AEFeinstein/Super-2024-Swadge-HW/README.md

# Super Magfest 2024 Swadge Hardware

## Welcome

This is the hardware repository for the Super Magfest 2024 Swadge.

The corresponding firmware repository for the Super Magfest 2024 Swadge [can be found here](https://github.com/AEFeinstein/Swadge-IDF-5.0).

If you have any questions, feel free to create a Github ticket or email us at circuitboards@magfest.org.

## Render

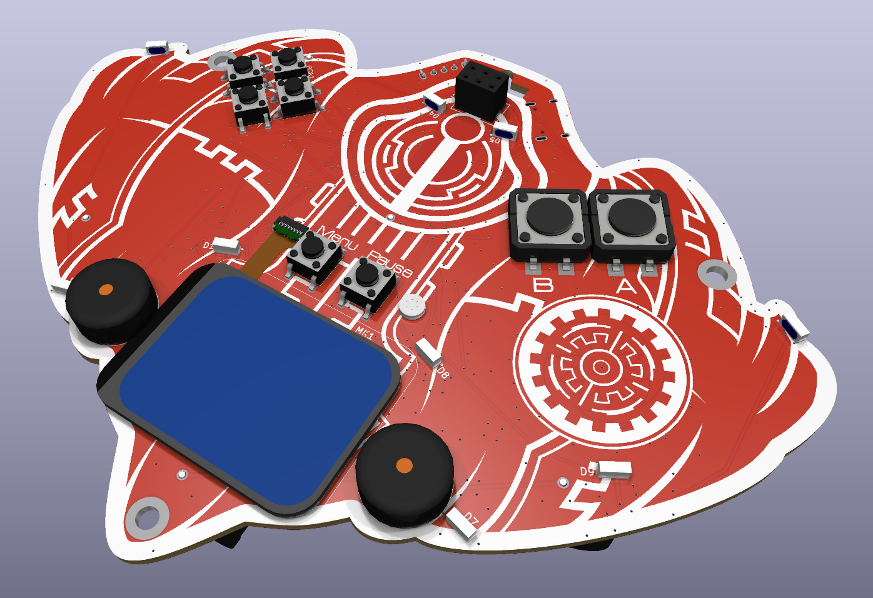
[picture p1: Swadge-HW/render.png]


## Schematic



## Directories

### `art`
This directory has the SVGs used to generate the KiCad files. The SVGs are drawn in [Inkscape](https://inkscape.org/) and exported with [Svg2Shenzhen](https://github.com/badgeek/svg2shenzhen)

### `Swadge-Parts`
This directory is a git submodule which has all the parts, footprints, and 3D models used in the KiCad project.

### `Swadge-HW`
This directory has the KiCad project for the main Swadge PCB.
