AEFeinstein/Super-2024-Swadge-HW/art/concept-art/Concept-Swadgeship-01.png

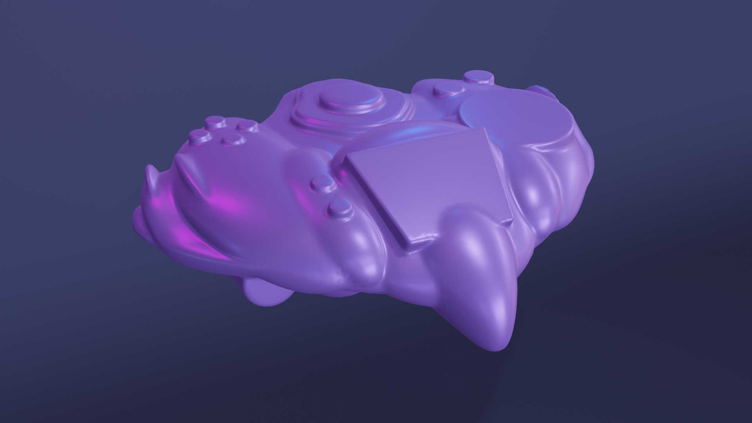
art/concept-art/Concept-Swadgeship-01.png
