AEFeinstein/Super-2024-Swadge-HW/art/concept-art/Ship-Original-Top.png

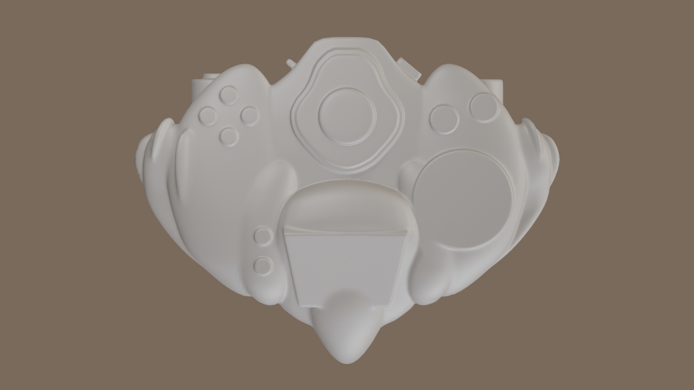
art/concept-art/Ship-Original-Top.png
