AEFeinstein/Super-2024-Swadge-HW/art/concept-art/zip_concept.jpg

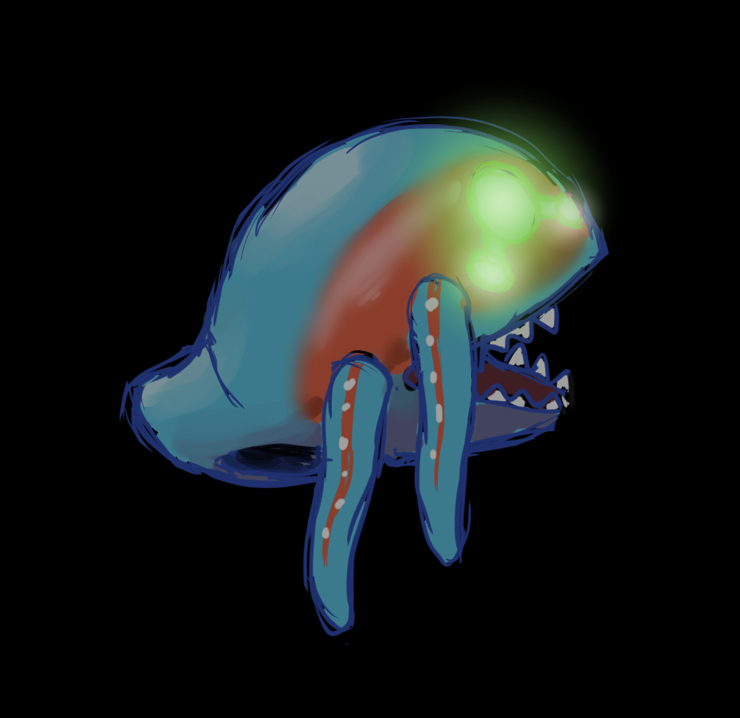
art/concept-art/zip_concept.jpg
