AEFeinstein/Super-2024-Swadge-HW/art/acrylic_3.dxf

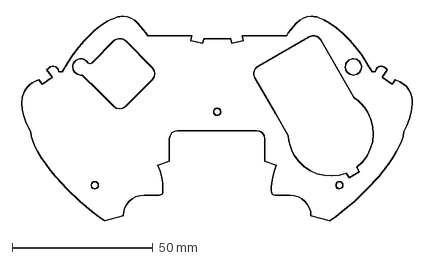
[picture p5: CAD file, 2023-09-23]
art/acrylic_3.dxf
144.3 x 72.8 mm
