AEFeinstein/Super-2024-Swadge-HW/Swadge-HW/3D-Print/GunShipShell_FDM.3mf

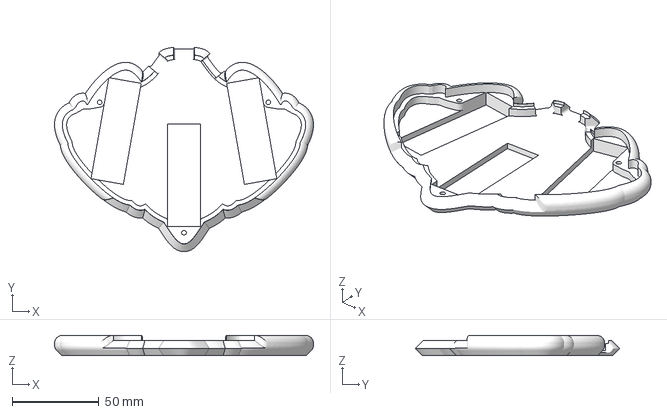
[picture p6: CAD file, 2023-09-25]
Swadge-HW/3D-Print/GunShipShell_FDM.3mf
149.0 x 117.5 x 11.6 mm
