AEFeinstein/Super-2024-Swadge-HW/Swadge-HW/package3d/acrylic-prototype_3.step

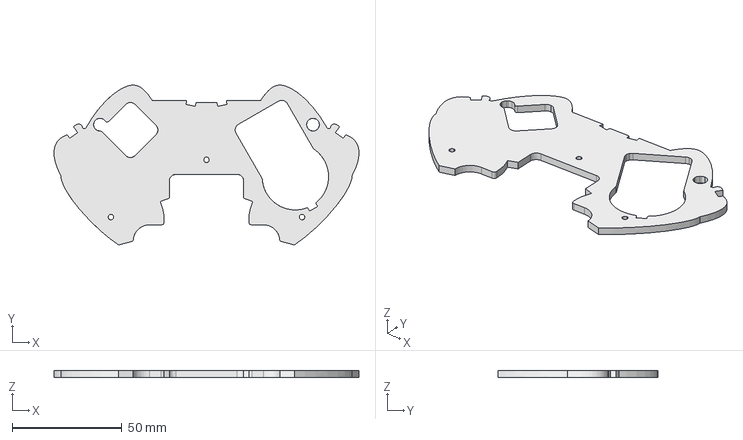
[picture p7: CAD file, 2023-09-23]
Swadge-HW/package3d/acrylic-prototype_3.step
138.9 x 72.8 x 3.00 mm
