AEFeinstein/Super-2024-Swadge-HW/art/acrylic_2.dxf

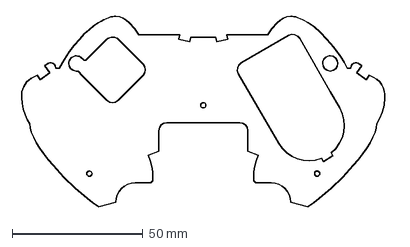
[picture p8: CAD file, 2023-09-05]
art/acrylic_2.dxf
144.3 x 72.8 mm
