AEFeinstein/Super-2024-Swadge-HW/Swadge-HW/package3d/acrylic-prototype.step

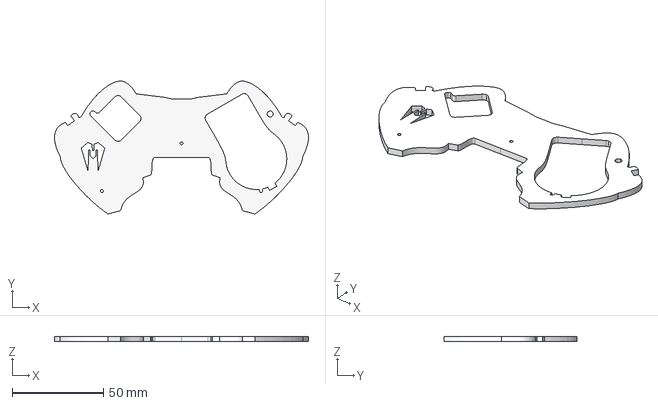
[picture p9: CAD file, 2023-07-24]
Swadge-HW/package3d/acrylic-prototype.step
138.9 x 72.7 x 3.00 mm
