AEFeinstein/Super-2024-Swadge-HW/Swadge-HW/3D-Print/Archive/ProtoShell02.3mf

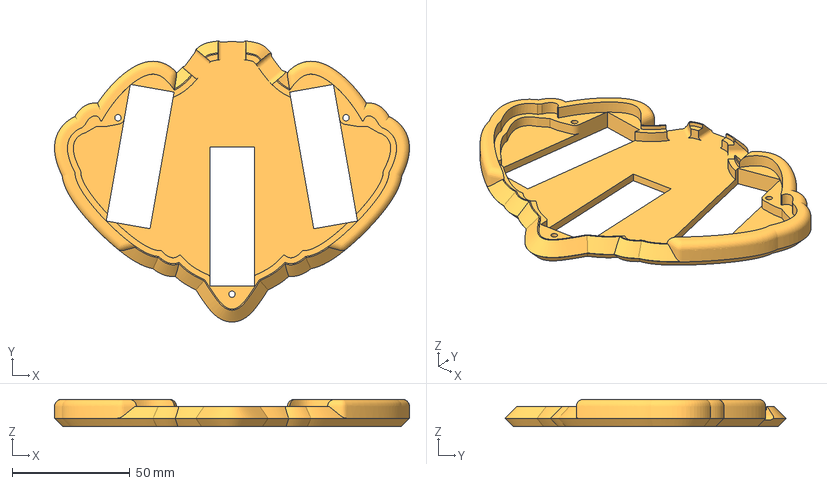
[picture p10: CAD file, 2023-09-15, an earlier design]
Swadge-HW/3D-Print/Archive/ProtoShell02.3mf
151.0 x 119.5 x 11.6 mm
