AEFeinstein/Super-2024-Swadge-HW/(list of files, cad)

Other CAD files:
Swadge-HW/3D-Print/Archive/ProtoShipShell02 v9.step
Swadge-HW/package3d/acrylic-prototype_2.step
Swadge-HW/3D-Print/Archive/ProtoShell02.stl
Swadge-HW/3D-Print/Archive/ProtoShipShell02 v9.stl
