AEFeinstein/Super-2024-Swadge-HW/(threads)

Thread 1 (2023-05-02):

Buzzer Improvements

AEFeinstein, 2023-05-02:
- [ ] Investigate a buzzer with a flatter frequency response (ZL-YDW1207-4005PA-5.0 favors high frequencies)
- [x] Investigate having two buzzers for stereo or polyphonic sound (budget permitting)
- [x] Investigate hardware mute switch rather than software setting

AEFeinstein, 2023-08-22:
Hardware mute isn't necessary with the quick setting menu.

I don't want to swap buzzers now, but this one would be a good candidate. It brings the resonant frequency down from 4000hz to 2300hz. It would require a footprint change

https://www.lcsc.com/product-detail/Buzzers_Jiangsu-Huaneng-Elec-HMB1206-03_C96101.html

Closed 2023-08-22.

Thread 2 (2023-05-02):

Microphone Improvements

AEFeinstein, 2023-05-02:
- [ ] Make sure Elecrow properly solders circuit. Is it possible to make it easier to solder?

cnlohr, 2023-06-07:
@AEFeinstein can you review:

Current microphone: [C2835889](https://www.lcsc.com/product-detail/Microphones_Goertek-B4013AM423-098_C2835889.html)

Microphone I've been playing with recently: (Is reverse-mount)
[C233789](https://www.lcsc.com/product-detail/MEMS-Microphones_Goertek-S08OB383-031_C233789.html)

AEFeinstein, 2023-06-07:
The reverse mount is like +$0.07, but otherwise appears to be a microphone. I'm not sure what you want me to review, but if you think the performance is worth the cost, we can at least put pads for it on the first proto.

cnlohr, 2023-06-07:
I do not feel strongly, but if there was ever a need/desire to have the component be not visible for artistic or other purposes, this is an option.

AEFeinstein, 2023-06-07:
Oh, if it's for aesthetics, I'm fine with the little button mic. I think that fits well as a detail on the gunship anyway. I'm mostly concerned with solderability, but maybe we can help elecrow out with a better footprint or something.

AEFeinstein, 2023-08-22:
The microphone on the first prototype didn't work, and this is noted in #11

AEFeinstein, 2023-09-26:
Mic on the second proto is A-OK

Closed 2023-09-26.

Thread 3 (2023-05-02):

LED Improvements

AEFeinstein, 2023-05-02:
- [x] Investigate acrylic diffuser. Elecrow now has an [acrylic cutting service](https://www.elecrow.com/acrylic-cutting.html). The following materials should be ordered and checked for optical properties
    * 000 - Transparent (probably too clear, engraving adds significant cost)
    * P422 - Matte Transparent (perhaps the only option)
    * 402 - White (check if translucent before ordering)
    * P402 - Matte White (check if translucent before ordering)
- [x] Investigate using cheaper SZLEDCO LEDs

AEFeinstein, 2023-06-07:
Test parts were ordered, waiting to receive and evaluate them

cnlohr, 2023-06-07:
Quote has been requested from SZLEDCO

AEFeinstein, 2023-08-22:
SZLEDCO are great

Closed 2023-08-22.

Thread 6 (2023-05-02):

Accelerometer Removal

AEFeinstein, 2023-05-02:
Unless a fair number of games or modes feature accelerometer control, remove it. It's not a great user experience to use it sparingly.

AEFeinstein, 2023-06-07:
Maybe. I don't remember current GPIO usage off the top of my head, but if we want a sixth pad for touch or a second buzzer line, they have to come from somewhere, and that somewhere could be the accel. Assuming GPIOs don't get stolen, I'm fine with just DNPing this

cnlohr, 2023-06-09:
considering we double-up these pins with the SAO header, that's another strike against that plan.

AEFeinstein, 2023-08-22:
Still unclear if these get removed or not, but it's covered in #11

Closed 2023-08-22.

Thread 7 (2023-05-02):

Power Circuitry Improvements

AEFeinstein, 2023-05-02:
- [x] Use physically smaller inductor
- [x] Don't place parts too close to battery footprint. The battery clip has some wiggle and can knock passives off

AEFeinstein, 2023-08-22:
@cnlohr I don't think you swapped the inductor. Either do that for the next rev or close this issue please.

AEFeinstein, 2023-08-30:
Smaller inductors have edges that may catch. Not swapping.

Closed 2023-08-30.

Thread 8 (2023-05-02):

Shape Improvements

AEFeinstein, 2023-05-02:
- [x] Make lanyard hole wide enough for plastic lanyard clips
- [x] Design shape with 3D printed shell in mind (mounting holes for shell? d-pad?)

Closed 2023-08-22.

Thread 11 (2023-08-14):

Rev- Fixes

cnlohr, 2023-08-14:
- [x] Microphone is laaaaaaame.  Switch to newly available microphone - https://www.lcsc.com/product-detail/Microphones_INGHAi-GMI4013S-2C58DB_C529870.html
- [x] Swap buttons (left/down)
- [x] Add copper behind the touch pad
- [x] Remove unused parts (gyro/accel/magnet), pending conversation
- [x] Add dot indicating pin 1 on SAO
- [x] Add silkscreen art
- [x] Move rear board components at least 2mm from board edge
- [x] Part movement and reroute. Move microphone from the nose to the gap between the menu/pause buttons and acrylic. Move the third screw hole from around the display to the nose. Delete the fourth screw hole around the display. Reroute as necessary. See quick example:
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

AEFeinstein, 2023-08-14:
And remove unused parts (magnetometer?)

cnlohr, 2023-08-15:
Add dot indicating pin 1 on SAO

AEFeinstein, 2023-08-15:
I strongly recommend adding copper behind the touch pad. I've noticed that the _back_ is touch sensitive on this rev, which isn't great.

AEFeinstein, 2023-08-15:
And I think we can get some art for rev2

AEFeinstein, 2023-08-23:
* cad972224555df497809eae80f3a85bdda3ab0e8 - Added dot to SAO
* a722288b943a128ea8e3cc8c8a3047e676b30b1c - Removed keepout behind touchpad
* c49fef01a56f8b0b280d5c99c38fbb450975cad4 - Swapped left and down buttons

eriktronic, 2023-08-27:
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
Move rear board components at least 2mm from board edge

cnlohr, 2023-08-28:
Change Log Summary, So far, in my new PR:
1. Move Microphone
2. Switch microphone for new mic.
3. Switch support circuitry for new mic.
4. Deleted extra screw.
5. Moved components on back in so that none are within 1mm of the edge.
6. Tweaked power for gyro.
7. Removed rumble drive circuitry.

Additional: Shrunk touch pad, it is now 24.5mm across.
Additional: Not sure why pinout on touchpad appeared different on updated touch pad - this should make them the same.

TODO:
- [ ] Add Silkscreen Art
- [ ] Pending, remove unused circuitry

AEFeinstein, 2023-08-28:
As noted in #14, once you remove unused circuitry give me the mutex and I'll apply art

cnlohr, 2023-08-29:
@AEFeinstein  Should I try using a smaller inductor for the display? It feels weird being the biggest chonker on the swadge.

cnlohr, 2023-08-29:
#14 Mutex released.

cnlohr, 2023-08-29:
Also - so you are aware, my new strategy is set min spacing to 7.2mil for DRC, and 8.2 for design.

That magnetometer is annoyying.

cnlohr, 2023-08-29:
Ugh... inductor wise, let's keep it.  All the other suitable ones look like they could snag. https://www.lcsc.com/product-detail/Inductors-SMD_Murata-Electronics-LQH32PZ100MNCL_C464437.html

AEFeinstein, 2023-08-29:
Keeping the more cube-ular inductor is A-OK.

AEFeinstein, 2023-08-30:
@cnlohr, I added art, tweaked some positions, and fixed DRC errors and warnings. I am done for the evening.

> Also - so you are aware, my new strategy is set min spacing to 7.2mil for DRC, and 8.2 for design.

FYI 8.2mil DRC for design threw a ton of errors, so I bumped it down to 0.2mm (7.87mil), which it looks like it was actually designed with. I also reassigned all track widths to their netclass width. It's nice.

> That magnetometer is annoyying.

Yes! I synced the board with `Swadge-Parts` so the footprint in use has pill-shaped pads, not rounded-square ones. I also overrode clearances for those four pads. I don't know what you want to do, but that'll be a quick chat before ordering.

Closed 2023-10-02.

Thread 13 (2023-08-26):

Scale down touch pad by 10-15%

Dacvak, 2023-08-26:

AEFeinstein, 2023-08-26:
What's the justification here?

cnlohr, 2023-08-29:
It both feels a tiiiny bit too big to me, and also it's harder to work through the deadzone.  By going to 24mm, and running our fingers around the far outside, we can have better control I feel.

When working on the shroud, be sure to add an edge beyond the size of the spinner, itself.

AEFeinstein, 2023-08-29:
I'll try to add a reasonable gap between the pad and the acrylic. I'll also be adding a courtyard to the part.

Closed 2023-08-30.

Thread 15 (2023-09-04):

Rev C fixes

cnlohr, 2023-09-04:
Just things I noticed post-submission
- [x] There is still silkscreen under antenna for esp - there should be no silkscreen.
- [x] R3's silkscreen is janked.
- [ ] Adjust C5 silkscreen to not look like "C51"
- [x] Try to hide front-side designator silkscreen under parts or acrylic (MK1, D1, J1)
- [x] We should have? or may (want)? to swap R10, R11 for 5.1k

AEFeinstein, 2023-09-05:
> There is still silkscreen under antenna for esp - there should be no silkscreen.

Does silkscreen impact RF performance? It's not metal...

cnlohr, 2023-09-26:
Not appreciably.  sorry, took til now to see this.

AEFeinstein, 2023-09-26:
Guess we're not changing the I2C pullups

cnlohr, 2023-10-02:
Sorry, forgot to mention - didn't want to change them.  We were already dropping the mag.

AEFeinstein, 2023-10-02:
> Adjust C5 silkscreen to not look like "C51"

Moved to #16

Closed 2023-10-02.

Thread 16 (2023-10-02):

Rev 1.0.0 Silkscreen Changes

AEFeinstein, 2023-10-02:
- [x] Add puzzle to the bottm
- [x]  Adjust C5 silkscreen to not look like "C51"

Current silkscreen:
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

AEFeinstein, 2023-10-08:
Done in 913542f40bd1546054c452497dc29488813f44fb

AEFeinstein, 2023-10-08:
@cnlohr FYI for silkscreen adjustments

Closed 2023-10-08.
