AEFeinstein/Super-2024-Swadge-HW/(commit log)

2023-05-02 Stripped out Super 2023 assets, erased layout, updated README.md
    [Eggshell_back_FDM.STL, Eggshell_back_SLA.STL, Eggshell_front_FDM.STL, Eggshell_front_SLA.STL, SAO1.kicad_pcb, SAO1.kicad_sch, Swadge-HW.kicad_pcb, Swadge-HW.kicad_sch]
2023-06-15 #1 Added second buzzer #5 Replaced touch strip with circular touch pad Moved TFT_FMARK to GPIO33 Added outline SVG
    [Swadge-HW.kicad_pcb, Swadge-HW.kicad_sch]
2023-06-16 Updated LEDs, started placement
    [Swadge-HW.kicad_pcb, Swadge-HW.kicad_sch]
2023-06-29 Rework shape and part placement
    [Swadge-HW.kicad_pcb]
2023-07-04 Flipped Swadge over
    [Swadge-HW.kicad_pcb]
2023-07-05 Flipped Swadge back over (undo)
    [Swadge-HW.kicad_pcb]
2023-07-05 Place LEDs, lose my mind
    [Swadge-HW.kicad_pcb]
2023-07-06 Adjust LED placement, ready for routing
    [Swadge-HW.kicad_pcb, Swadge-HW.kicad_sch]
2023-07-06 SCH cleanup, added missing D9 connections
    [Swadge-HW.kicad_pcb, Swadge-HW.kicad_sch]
2023-07-07 Add courtyards for parts, move D9 LED
    [Swadge-HW.kicad_pcb]
2023-07-07 Add prototype acrylic SVG
2023-07-12 Flip ESP attempt
    [Swadge-HW.kicad_pcb, Swadge-HW.kicad_sch]
2023-07-12 Unflipped ESP
    [Swadge-HW.kicad_pcb]
2023-07-12 Unflipped update - fully routed.
    [Swadge-HW.kicad_pcb]
2023-07-12 Updates! Add rest of "wish" parts.
    [Swadge-HW.kicad_pcb, Swadge-HW.kicad_sch]
2023-07-13 Initial rev - for order.
    [Swadge-HW.kicad_pcb, Swadge-HW.kicad_sch]
2023-07-18 Add holes, fix all DRC errors and most warnings
    [Swadge-HW.kicad_pcb, Swadge-HW.kicad_sch]
2023-07-20 Replaced ESP32-S2-SOLO with -MINI
    [Swadge-HW.kicad_sch]
2023-07-20 Updated PCB, needs routing
    [Swadge-HW.kicad_pcb]
2023-07-21 Added Gunship symbol & footprint w/ acrylic
    [acrylic-prototype.step]
2023-07-21 Added acrylic to schematic and layout
    [Swadge-HW.kicad_pcb, Swadge-HW.kicad_sch]
2023-07-22 Routed ESP32-S2-MINI
    [Swadge-HW.kicad_pcb]
2023-07-22 Added metal to mounting holes, cleanup
    [Swadge-HW.kicad_pcb, Swadge-HW.kicad_sch]
2023-07-23 Replaced microphone, added touch keepout
    [Swadge-HW.kicad_pcb, Swadge-HW.kicad_sch]
2023-07-24 Update rev - order to what was actually ordered.
    [Swadge-HW.kicad_pcb, Swadge-HW.kicad_sch]
2023-07-24 Few minor tweaks recommended by JLCPCB. I guess this is rev - 2 * Actually remove LCSC part # from J3 * Fix solder mask / paste holes on U9
    [Swadge-HW.kicad_pcb, Swadge-HW.kicad_sch]
2023-08-23 Routed power traces away from lanyard hole
    [Swadge-HW.kicad_pcb]
2023-08-23 Removed keepout behind touchpad
    [Swadge-HW.kicad_pcb]
2023-08-23 Swapped left and down buttons
    [Swadge-HW.kicad_pcb]
2023-08-23 Added dot to SAO connector
    [Swadge-HW.kicad_pcb]
2023-08-28 Update from first round.
    * Move Microphone
    * Switch microphone for new mic.
    * Switch support circuitry for new mic.
    * Deleted extra screw.
    * Moved components on back in so that none are within 1mm of the edge.
    * Tweaked power for gyro.
    * Removed rumble drive circuitry.
    * Tweaked footprint on magnetometer.
    Additional: Shrunk touch pad, it is now 24.5mm across.
    Additional: Not sure why pinout on touchpad appeared different on updated touch pad - this should make them the same.
    [Swadge-HW.kicad_pcb, Swadge-HW.kicad_sch]
2023-08-29 * Remove old accel. * Move traces around.
    [Swadge-HW.kicad_pcb, Swadge-HW.kicad_sch]
2023-08-29 Update from recommendations in PR 14
    [Swadge-HW.kicad_pcb]
2023-08-30 Added silkscreen
    [Swadge-HW.kicad_pcb]
2023-08-30 Updated netclass clearances Set up Power netclass Reassigned all traces to netclass width Synced parts with Swadge-Parts Fixed all but two DRCs Adjusted silkscreen
    [Swadge-HW.kicad_pcb]
2023-08-30 Use rounded square pads for magnetometer
    [Swadge-HW.kicad_pcb]
2023-08-30 Updated magnetometer
    [Swadge-HW.kicad_pcb]
2023-09-02 * Move Magnetometer
    [Swadge-HW.kicad_pcb, Swadge-HW.kicad_sch]
2023-09-03 * Optimize some parts, i.e. 100ohm -> 33 ohm, 22 ohm -> 33 ohm * Isolate magnetometer. * Set more parts to be not-in-BOM.
    [Swadge-HW.kicad_pcb, Swadge-HW.kicad_sch]
2023-09-05 Added new acrylic for 2nd proto
    [acrylic-prototype_2.step, acrylic_2.dxf]
2023-09-05 Fix up 3D models
    [Swadge-HW.kicad_pcb, Swadge-HW.kicad_sch]
2023-09-15 Uploaded STL, 3MF, and Fusion 360 source file
    Fusion file contains several bodies/components named cutouts that define how the shell is hollowed out. They are stored individually, but also combined into a singular object for the purpose of hollowing out an alternate shell shape. Hole size and board/battery clearance can be quickly changed with user parameter list.
    [ProtoShell02.3mf, ProtoShell02.stl]
2023-09-18 Update R3 to 12k, for correct microphone bias.
    [Swadge-HW.kicad_pcb, Swadge-HW.kicad_sch]
2023-09-23 Add larger courtyard around touchpad, move D9, add teardrops
    [Swadge-HW.kicad_pcb, acrylic-prototype_3.step]
2023-09-23 Updated silkscreen with text
2023-09-23 Added updated acrylic DXF
    [acrylic_3.dxf]
2023-09-25 Updated shell geometry
    Widened USB cutout, updated fillet and chamfer dimensions.
    [ProtoShipShell02 v9.3mf, ProtoShipShell02 v9.step, ProtoShipShell02 v9.stl]
2023-09-26 Update silk to v1.0.0. Relink parts
    [Swadge-HW.kicad_sch]
2023-09-26 Fix with DNP parts + v1.0.0 release.
    [Swadge-HW.kicad_sch]
2023-10-08 Fixed silkscreen part numbers. Added clue. Bumped to v1.0.1
2023-10-30 Final silkscreen
2023-12-04 Folder cleanup, add source files, readme
    [ProtoShell02.3mf, ProtoShell02.stl, ProtoShipShell02 v9.step, ProtoShipShell02 v9.stl]
2023-12-04 File cleanup
    move protoshell file, rename for clarity
    [GunShipShell_FDM.3mf]
2024-01-14 Updated geometry - Use this file to 3D print.
    Updated geometry to include chamfers at screw locations, and power switch cutout. M3x8 screws recommended.
2024-05-04 Add render and schematic
